yarosdytko/8Bit-bag/Firmware ESP32/Firmware/timerMinim.h

class timerMinim
{
  public:
    timerMinim(uint32_t interval);        // declaracion del timer con intervalo de tiempo
    void setInterval(uint32_t interval);  // intervalo de tiempo para timer
    boolean isReady();                    // devuelve true cuando timer esta listo
    void reset();                         // reset del temporizador

  private:
    uint32_t _timer = 0;
    uint32_t _interval = 0;
};

timerMinim::timerMinim(uint32_t interval) {
  _interval = interval;
  _timer = millis();
}

void timerMinim::setInterval(uint32_t interval) {
  _interval = interval;
}

boolean timerMinim::isReady() {
  if ((long)millis() - _timer >= _interval) {
    _timer = millis();
    return true;
  } else {
    return false;
  }
}

void timerMinim::reset() {
  _timer = millis();
}
