yarosdytko/8Bit-bag/Firmware ESP32/Firmware/utility.ino

//funciones y rutinas de funcionamiento interno

//gamma correction arrays
const uint8_t PROGMEM gammaR[] = {
  0,  0,  0,  0,  0,  0,  0,  0,  0,  0,  0,  0,  0,  0,  0,  0,
  0,  0,  0,  0,  0,  0,  0,  0,  0,  0,  0,  0,  0,  1,  1,  1,
  1,  1,  1,  1,  1,  1,  1,  1,  1,  1,  1,  2,  2,  2,  2,  2,
  2,  2,  2,  3,  3,  3,  3,  3,  3,  3,  4,  4,  4,  4,  4,  5,
  5,  5,  5,  5,  6,  6,  6,  6,  7,  7,  7,  7,  8,  8,  8,  9,
  9,  9, 10, 10, 10, 11, 11, 11, 12, 12, 12, 13, 13, 14, 14, 14,
  15, 15, 16, 16, 17, 17, 18, 18, 19, 19, 20, 20, 21, 21, 22, 22,
  23, 24, 24, 25, 25, 26, 27, 27, 28, 29, 29, 30, 31, 31, 32, 33,
  33, 34, 35, 36, 36, 37, 38, 39, 40, 40, 41, 42, 43, 44, 45, 46,
  46, 47, 48, 49, 50, 51, 52, 53, 54, 55, 56, 57, 58, 59, 60, 61,
  62, 63, 65, 66, 67, 68, 69, 70, 71, 73, 74, 75, 76, 78, 79, 80,
  81, 83, 84, 85, 87, 88, 89, 91, 92, 94, 95, 97, 98, 99, 101, 102,
  104, 105, 107, 109, 110, 112, 113, 115, 116, 118, 120, 121, 123, 125, 127, 128,
  130, 132, 134, 135, 137, 139, 141, 143, 145, 146, 148, 150, 152, 154, 156, 158,
  160, 162, 164, 166, 168, 170, 172, 174, 177, 179, 181, 183, 185, 187, 190, 192,
  194, 196, 199, 201, 203, 206, 208, 210, 213, 215, 218, 220, 223, 225, 227, 230
};

const uint8_t PROGMEM gammaG[] = {
  0,  0,  0,  0,  0,  0,  0,  0,  0,  0,  0,  0,  0,  0,  0,  0,
  0,  0,  0,  0,  0,  0,  0,  0,  0,  0,  0,  0,  1,  1,  1,  1,
  1,  1,  1,  1,  1,  1,  1,  1,  1,  2,  2,  2,  2,  2,  2,  2,
  2,  3,  3,  3,  3,  3,  3,  3,  4,  4,  4,  4,  4,  5,  5,  5,
  5,  6,  6,  6,  6,  7,  7,  7,  7,  8,  8,  8,  9,  9,  9, 10,
  10, 10, 11, 11, 11, 12, 12, 13, 13, 13, 14, 14, 15, 15, 16, 16,
  17, 17, 18, 18, 19, 19, 20, 20, 21, 21, 22, 22, 23, 24, 24, 25,
  25, 26, 27, 27, 28, 29, 29, 30, 31, 32, 32, 33, 34, 35, 35, 36,
  37, 38, 39, 39, 40, 41, 42, 43, 44, 45, 46, 47, 48, 49, 50, 50,
  51, 52, 54, 55, 56, 57, 58, 59, 60, 61, 62, 63, 64, 66, 67, 68,
  69, 70, 72, 73, 74, 75, 77, 78, 79, 81, 82, 83, 85, 86, 87, 89,
  90, 92, 93, 95, 96, 98, 99, 101, 102, 104, 105, 107, 109, 110, 112, 114,
  115, 117, 119, 120, 122, 124, 126, 127, 129, 131, 133, 135, 137, 138, 140, 142,
  144, 146, 148, 150, 152, 154, 156, 158, 160, 162, 164, 167, 169, 171, 173, 175,
  177, 180, 182, 184, 186, 189, 191, 193, 196, 198, 200, 203, 205, 208, 210, 213,
  215, 218, 220, 223, 225, 228, 231, 233, 236, 239, 241, 244, 247, 249, 252, 255
};

const uint8_t PROGMEM gammaB[] = {
  0,  0,  0,  0,  0,  0,  0,  0,  0,  0,  0,  0,  0,  0,  0,  0,
  0,  0,  0,  0,  0,  0,  0,  0,  0,  0,  0,  0,  0,  0,  0,  1,
  1,  1,  1,  1,  1,  1,  1,  1,  1,  1,  1,  1,  1,  2,  2,  2,
  2,  2,  2,  2,  2,  2,  3,  3,  3,  3,  3,  3,  3,  4,  4,  4,
  4,  4,  5,  5,  5,  5,  5,  6,  6,  6,  6,  6,  7,  7,  7,  8,
  8,  8,  8,  9,  9,  9, 10, 10, 10, 10, 11, 11, 12, 12, 12, 13,
  13, 13, 14, 14, 15, 15, 15, 16, 16, 17, 17, 18, 18, 19, 19, 19,
  20, 20, 21, 22, 22, 23, 23, 24, 24, 25, 25, 26, 27, 27, 28, 28,
  29, 30, 30, 31, 32, 32, 33, 34, 34, 35, 36, 37, 37, 38, 39, 40,
  40, 41, 42, 43, 44, 44, 45, 46, 47, 48, 49, 50, 51, 51, 52, 53,
  54, 55, 56, 57, 58, 59, 60, 61, 62, 63, 64, 65, 66, 67, 69, 70,
  71, 72, 73, 74, 75, 77, 78, 79, 80, 81, 83, 84, 85, 86, 88, 89,
  90, 92, 93, 94, 96, 97, 98, 100, 101, 103, 104, 106, 107, 109, 110, 112,
  113, 115, 116, 118, 119, 121, 122, 124, 126, 127, 129, 131, 132, 134, 136, 137,
  139, 141, 143, 144, 146, 148, 150, 152, 153, 155, 157, 159, 161, 163, 165, 167,
  169, 171, 173, 175, 177, 179, 181, 183, 185, 187, 189, 191, 193, 196, 198, 200
};

//correccion de gama, colores mas naturales
uint32_t gammaCorrection(uint32_t color) {
  byte r = (color >> 16) & 0xFF;  // Extrae RR byte
  byte g = (color >> 8) & 0xFF;   // Extrae GG byte
  byte b = color & 0xFF;          // Extrar BB byte

  r = pgm_read_byte(&gammaR[r]);
  g = pgm_read_byte(&gammaG[g]);
  b = pgm_read_byte(&gammaB[b]);

  uint32_t newColor = ((long)(r & 0xff) << 16) + ((long)(g & 0xff) << 8) + ((long)b & 0xff);
  return newColor;
}

//obtener color por numero de led(pixel)
uint32_t getPixColor(int pixel) {
  if (pixel < 0 || pixel > NUM_LEDS - 1) return 0;
  return (((uint32_t)leds[pixel].r << 16) | ((long)leds[pixel].g << 8 ) | (long)leds[pixel].b);
}

//obtener color por coordenada X Y
uint32_t getPixColorXY(int x, int y) {
  return getPixColor(getPixelNumber(x, y));
}

//cambiar color global
void setColor(uint32_t c) {
  if (c != globalColor) {
    globalColor = gammaCorrection(c);
    Serial.print("Nuevo color: ");
    Serial.println(globalColor);
  }
}

// dibujar pixel segun coordenadas X Y
void drawPixelXY(int  x, int y, unsigned long int color) {
  if (x < 0 || x > WIDTH - 1 || y < 0 || y > HEIGHT - 1) return;
  int thisPixel = getPixelNumber(x, y);
  leds[thisPixel] = color;
}


// obtener el numero de pixel en la matriz
int getPixelNumber(int  x, int y) {
  if ((y % 2 == 0)) {
    return (y * WIDTH + x);
  } else {
    return (y * WIDTH + WIDTH - x - 1);
  }
}

//efectos fade

void fader(byte step) {
  for (byte i = 0; i < WIDTH; i++) {
    for (byte j = 0; j < HEIGHT; j++) {
      fadePixel(i, j, step);
    }
  }
}

void fadePixel(byte i, byte j, byte step) {
  int pixelNum = getPixelNumber(i, j);
  if (getPixColor(pixelNum) == 0) return;

  if (leds[pixelNum].r >= 30 ||
      leds[pixelNum].g >= 30 ||
      leds[pixelNum].b >= 30) {
    leds[pixelNum].fadeToBlackBy(step);
  } else {
    leds[pixelNum] = 0;
  }
}
