yarosdytko/8Bit-bag/(commit log)

2019-12-03 subida de archivos
2019-12-03 new file: 8Bit Bag.pptx new file: 8Bit bag BT control- proyecto Android Studio/.gitignore new file: 8Bit bag BT control- proyecto Android Studio/app/.gitignore new file: 8Bit bag BT control- proyecto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
    [lista de parametros.txt]
